denjhang/FM-Tower/ym2610_chip_sample.jpg

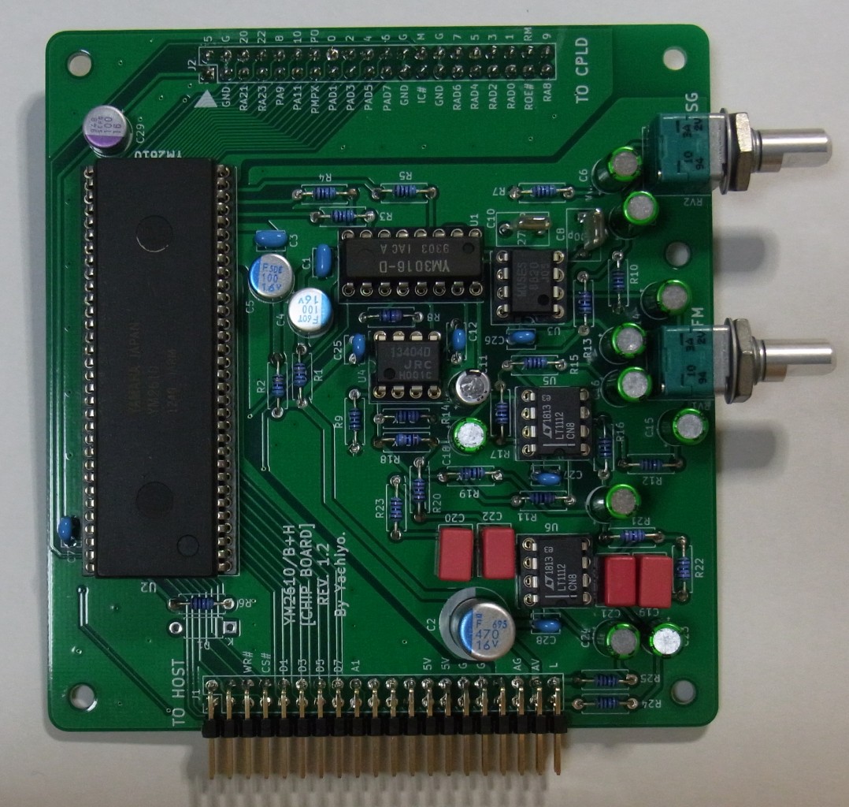
ym2610_chip_sample.jpg
