denjhang/FM-Tower/DAC_Unit_Rev1_0.png

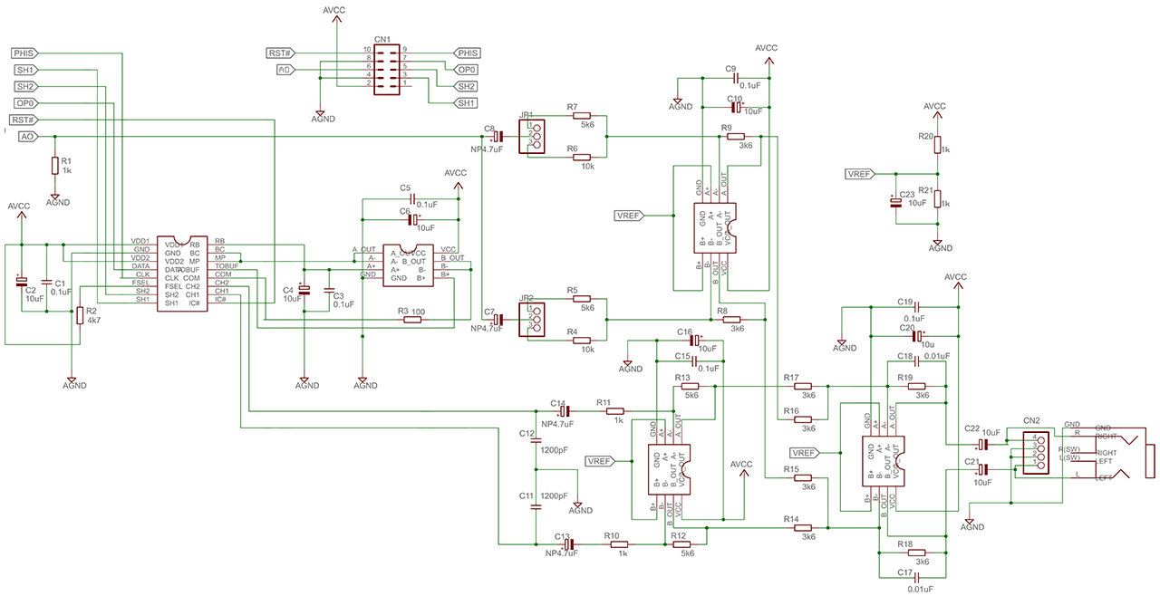
DAC_Unit_Rev1_0.png
