denjhang/FM-Tower/IF_Unit_Rev1_0b.png

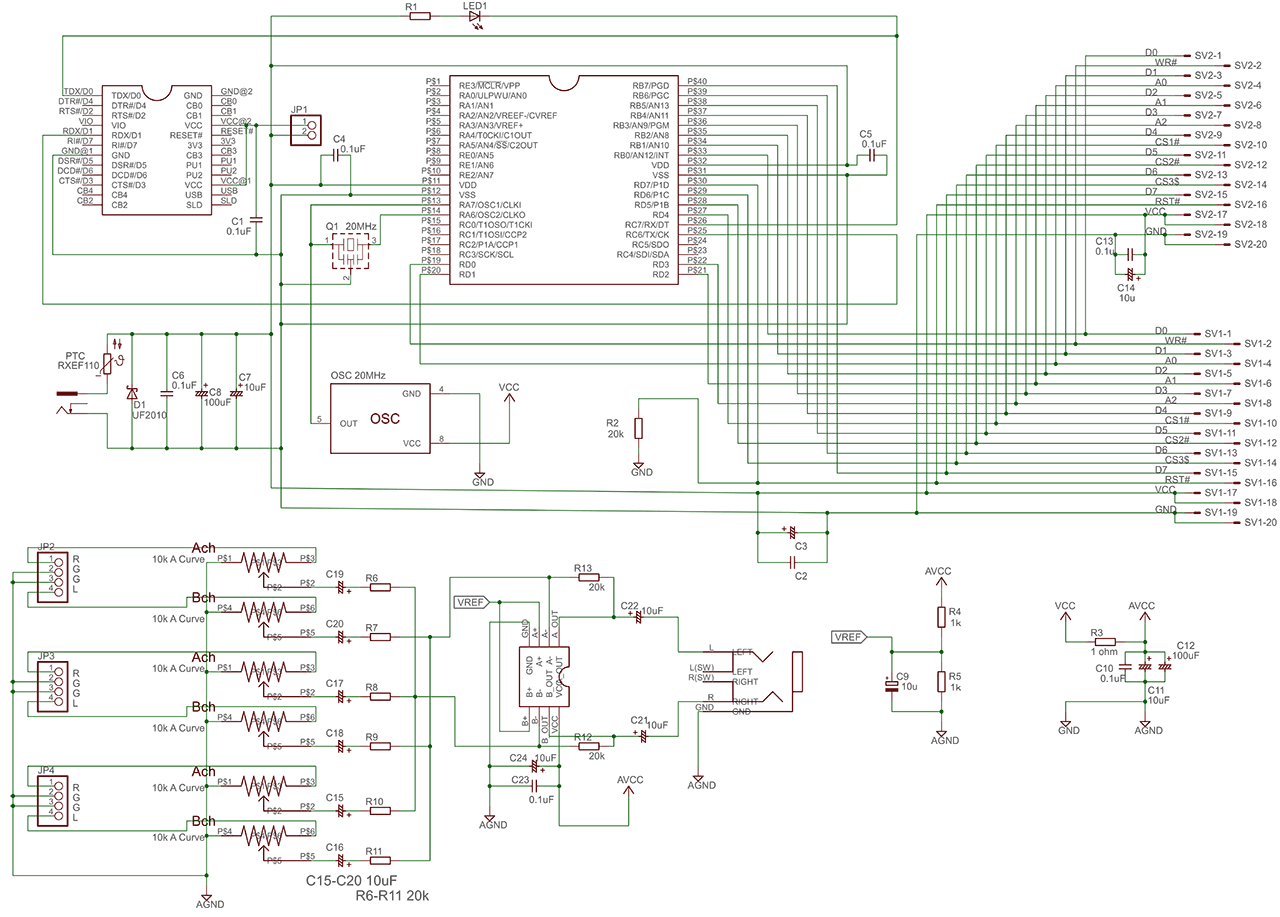
IF_Unit_Rev1_0b.png
