denjhang/FM-Tower/YM2151_Unit_Rev1_0.png

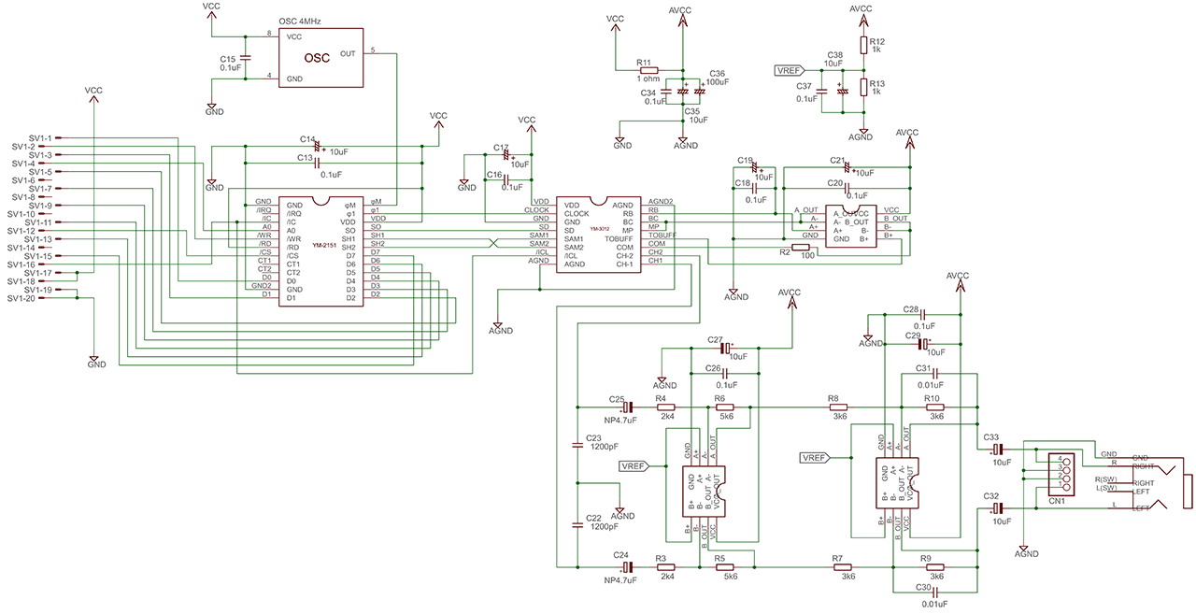
YM2151_Unit_Rev1_0.png
