denjhang/FM-Tower/ym2610_board.png

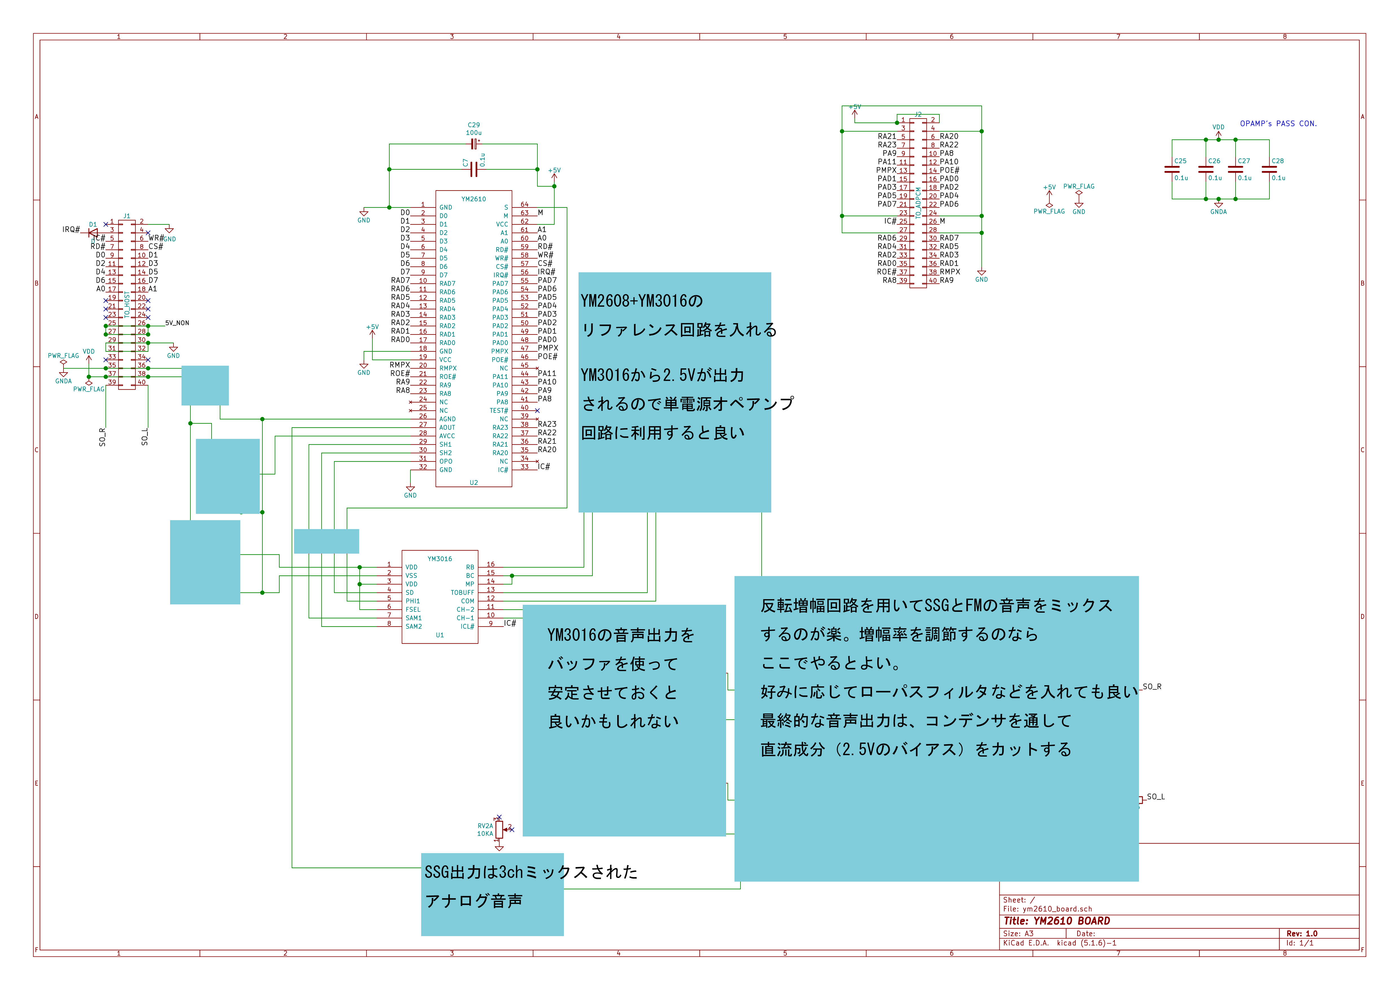
ym2610_board.png
