denjhang/FM-Tower/YM2610_Unit_Rev2_1.png

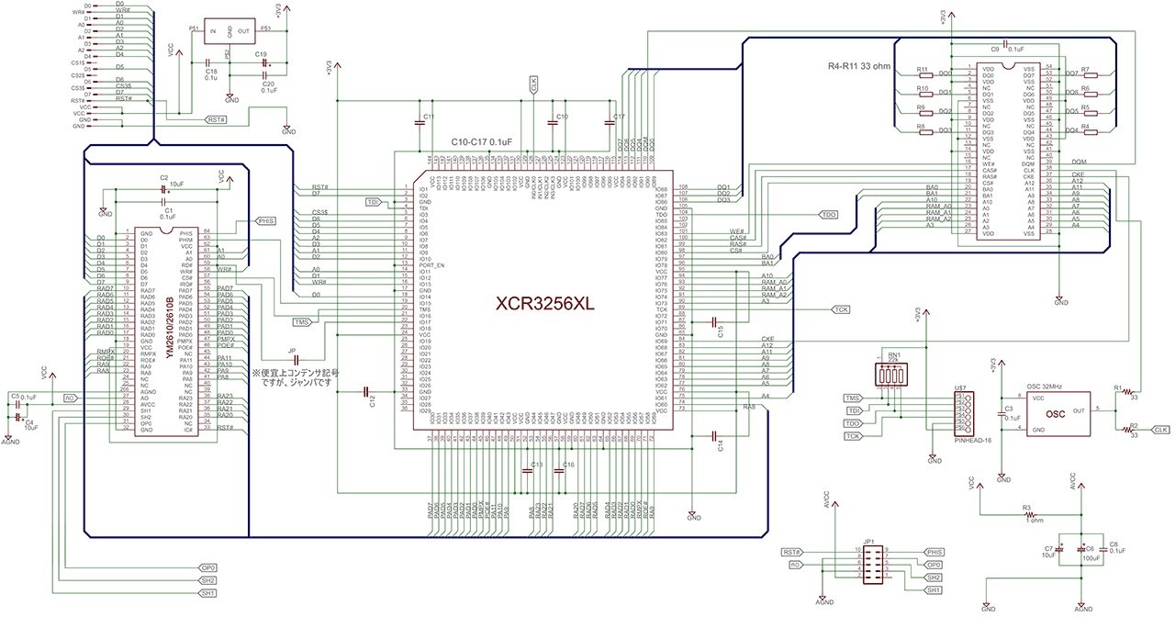
YM2610_Unit_Rev2_1.png
