denjhang/FM-Tower/YM2608_Unit_FIX@2x.png

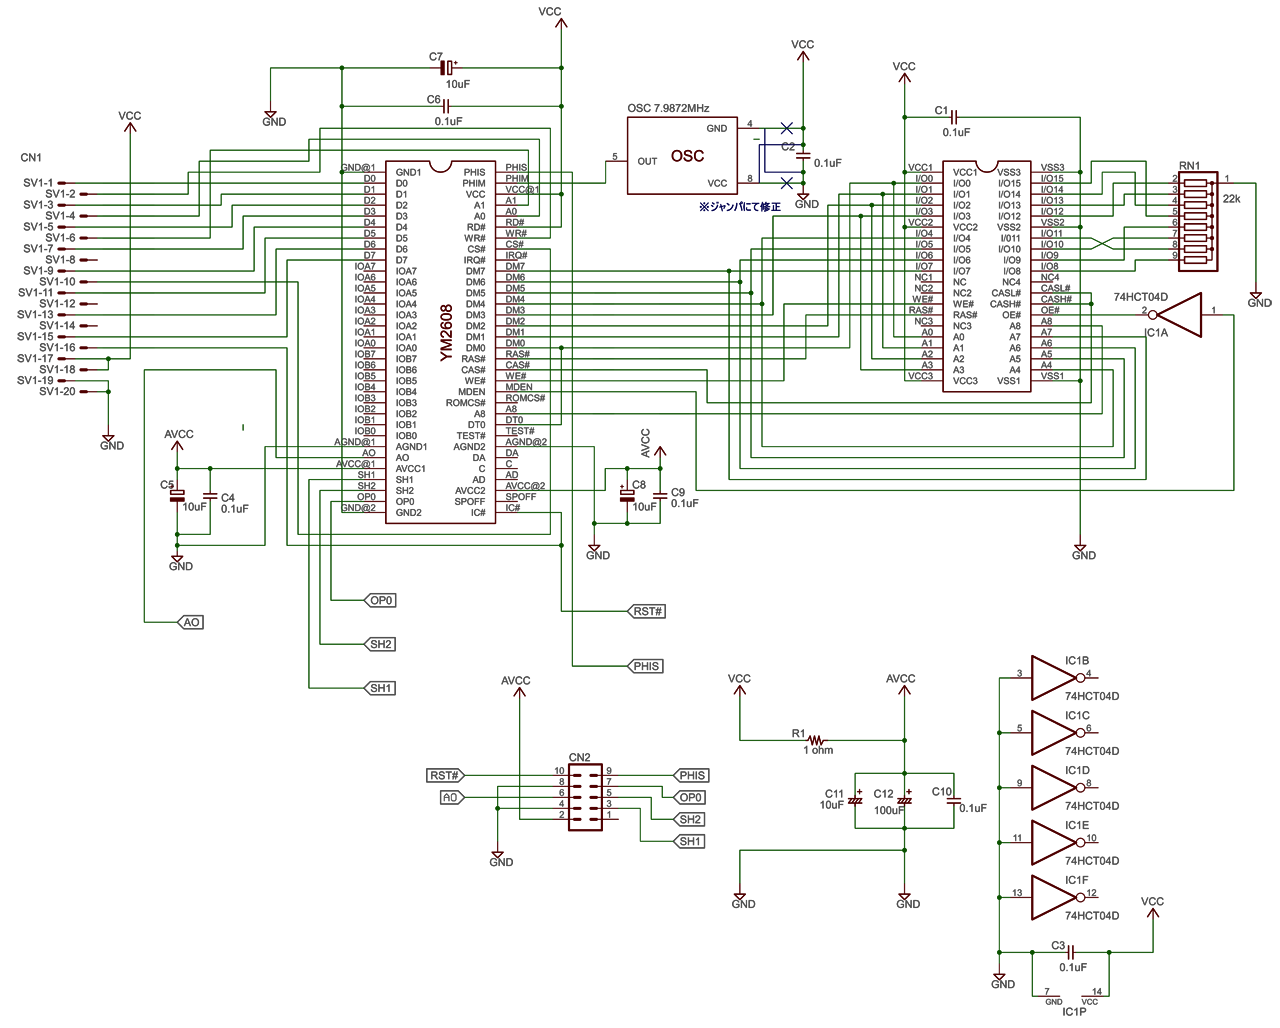
YM2608_Unit_FIX@2x.png
