denjhang/FM-Tower/altera_ymb_cpld_scheme.pdf

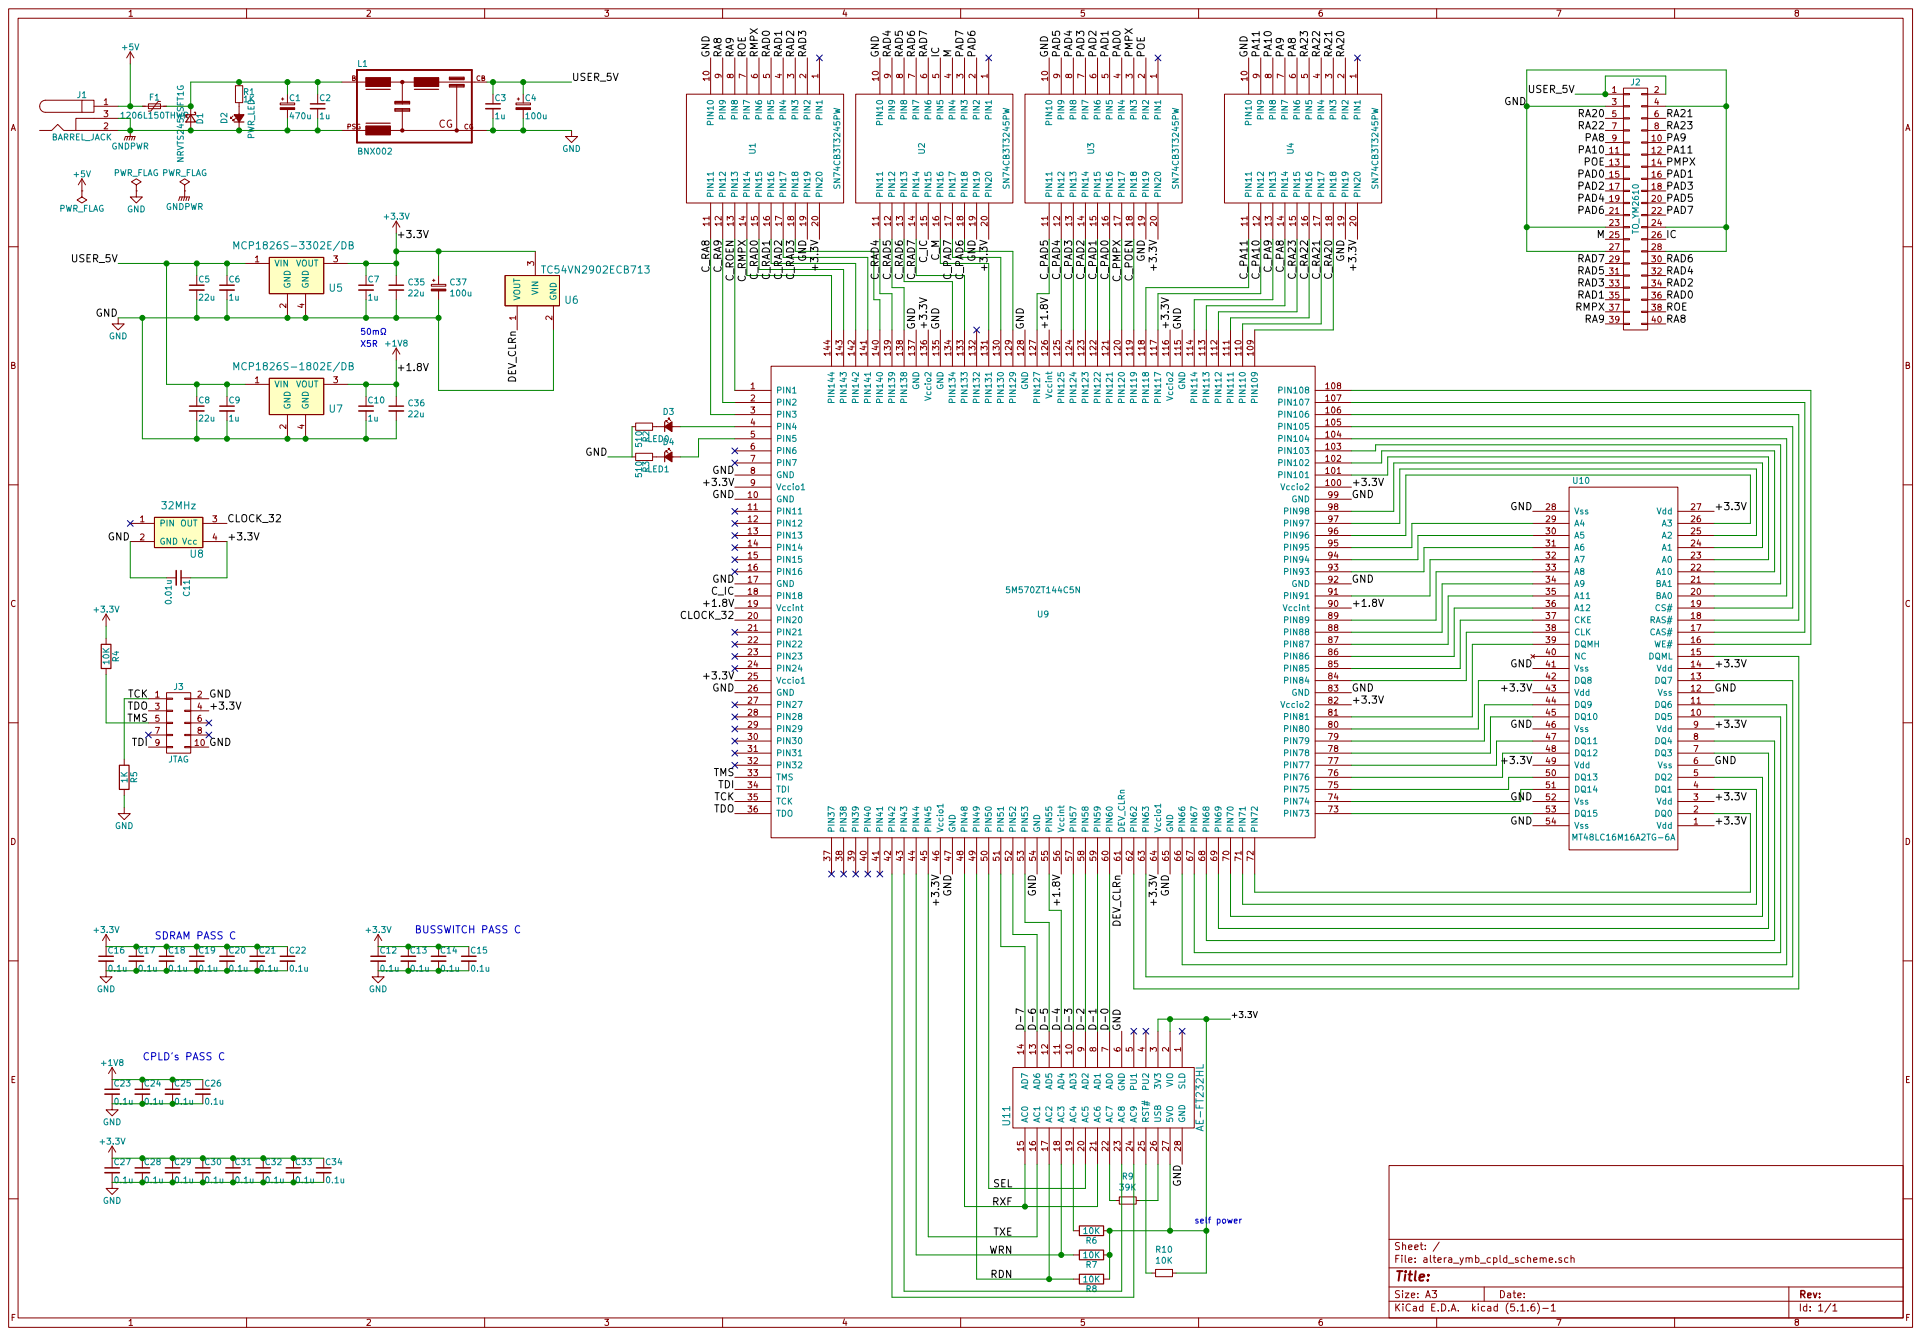
[picture p12: page 1]

File: altera_ymb_cpld_scheme.sch Sheet: / +3.3V GND
