denjhang/FM-Tower/udpl_mother_r13.pdf

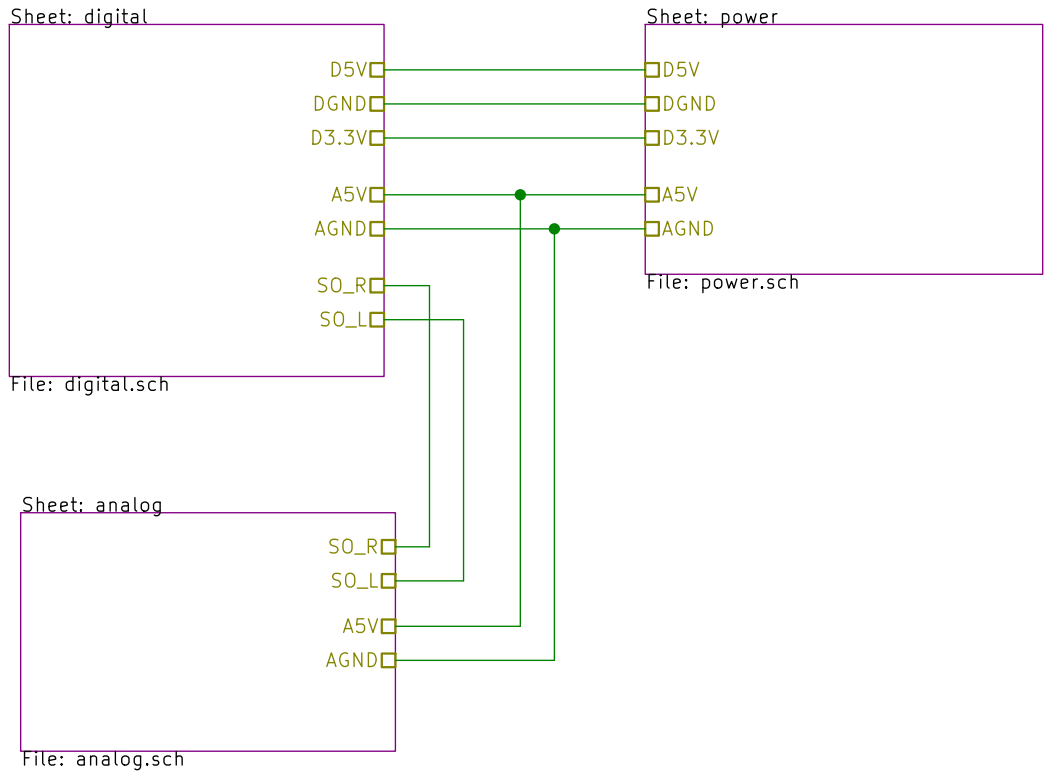
[picture p13: page 1]

File: power.sch D5V DGND

File: udpl_mother.sch Sheet: / yachiyo

Id: 1/4 Title: WiFi and PLL sound mother

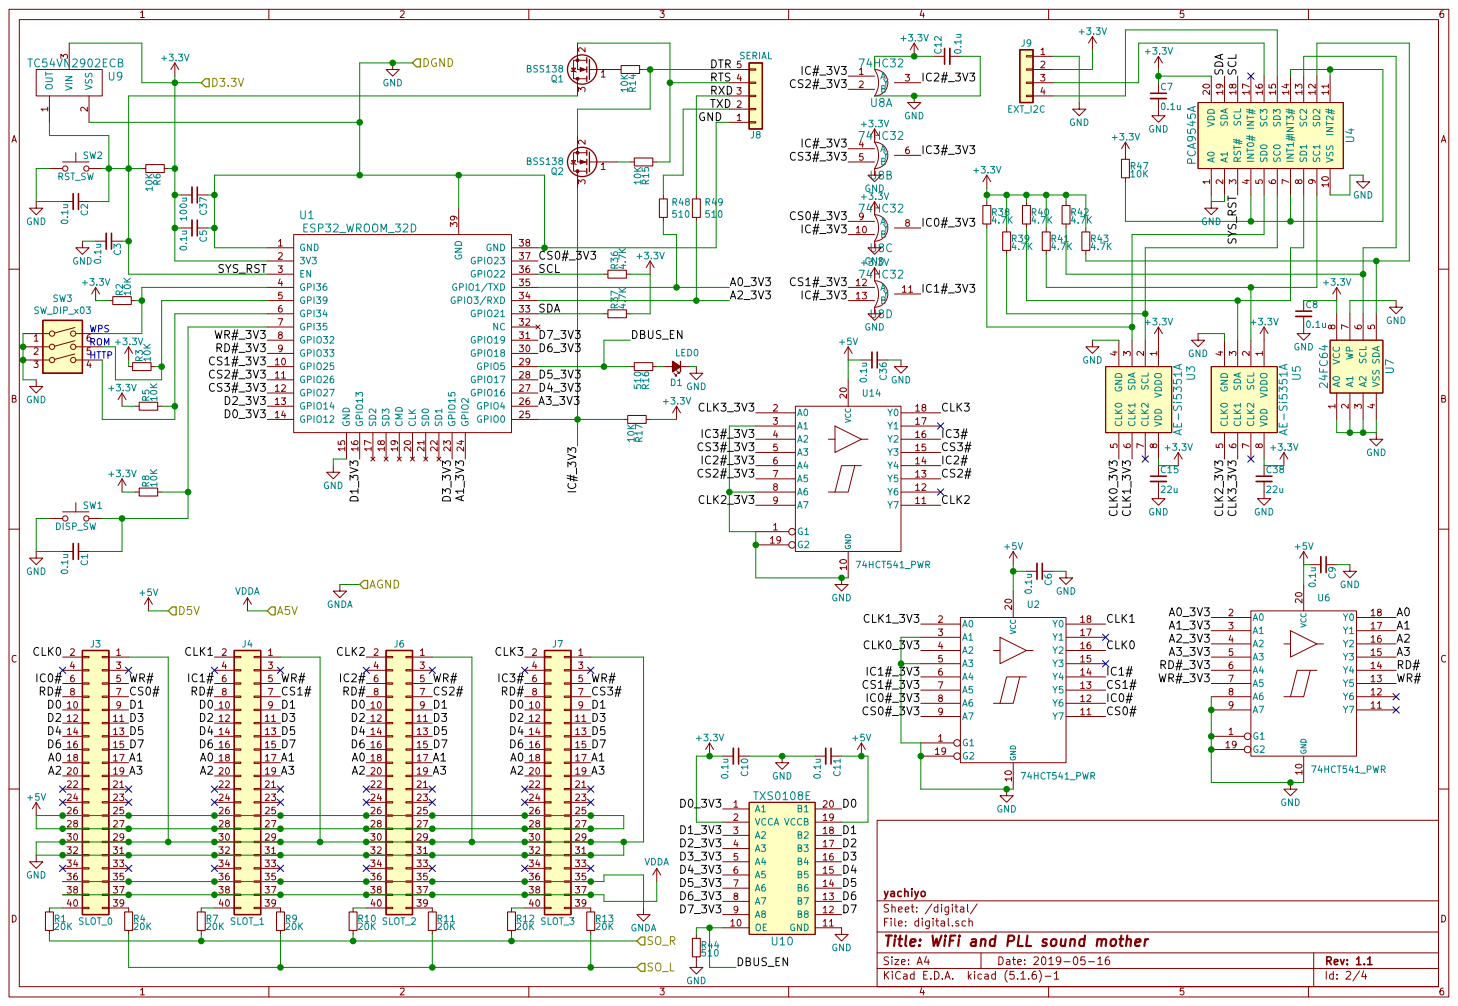
[picture p14: page 2]

9 VSS 10 VDD 20 INT2# 11 SD2 12 SC2 13 INT3# 14 SD3 15 SC3 16 INT# 17 SCL 18 SDA 19 U4 PCA9545A

TXD 2

yachiyo
Sheet: /digital/
File: digital.sch
Id: 2/4 Title: WiFi and PLL sound mother

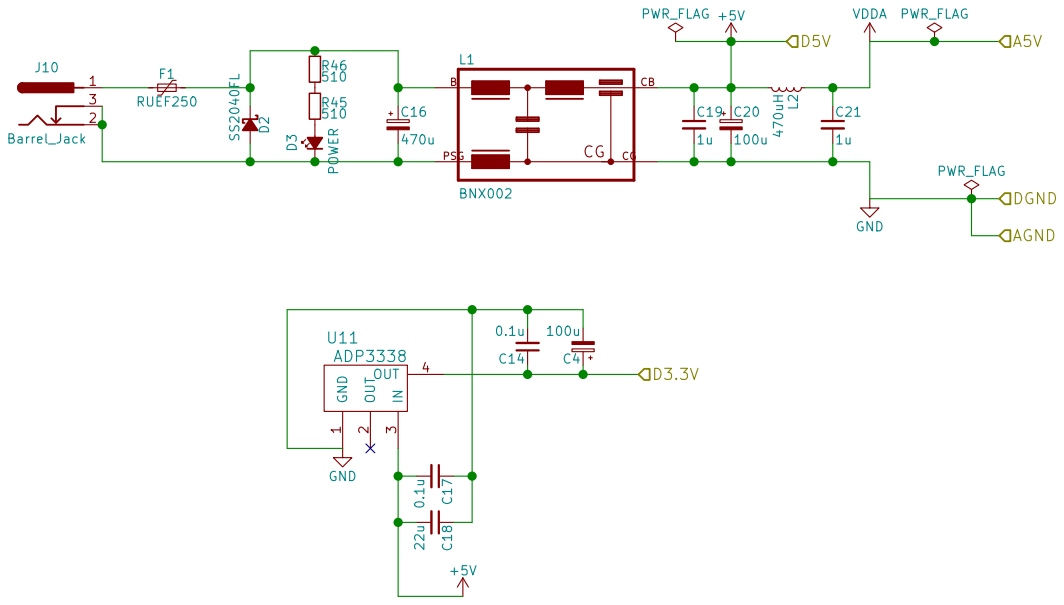
[picture p15: page 3]

yachiyo
Sheet: /power/
File: power.sch
Id: 3/4 Title: WiFi and PLL sound mother

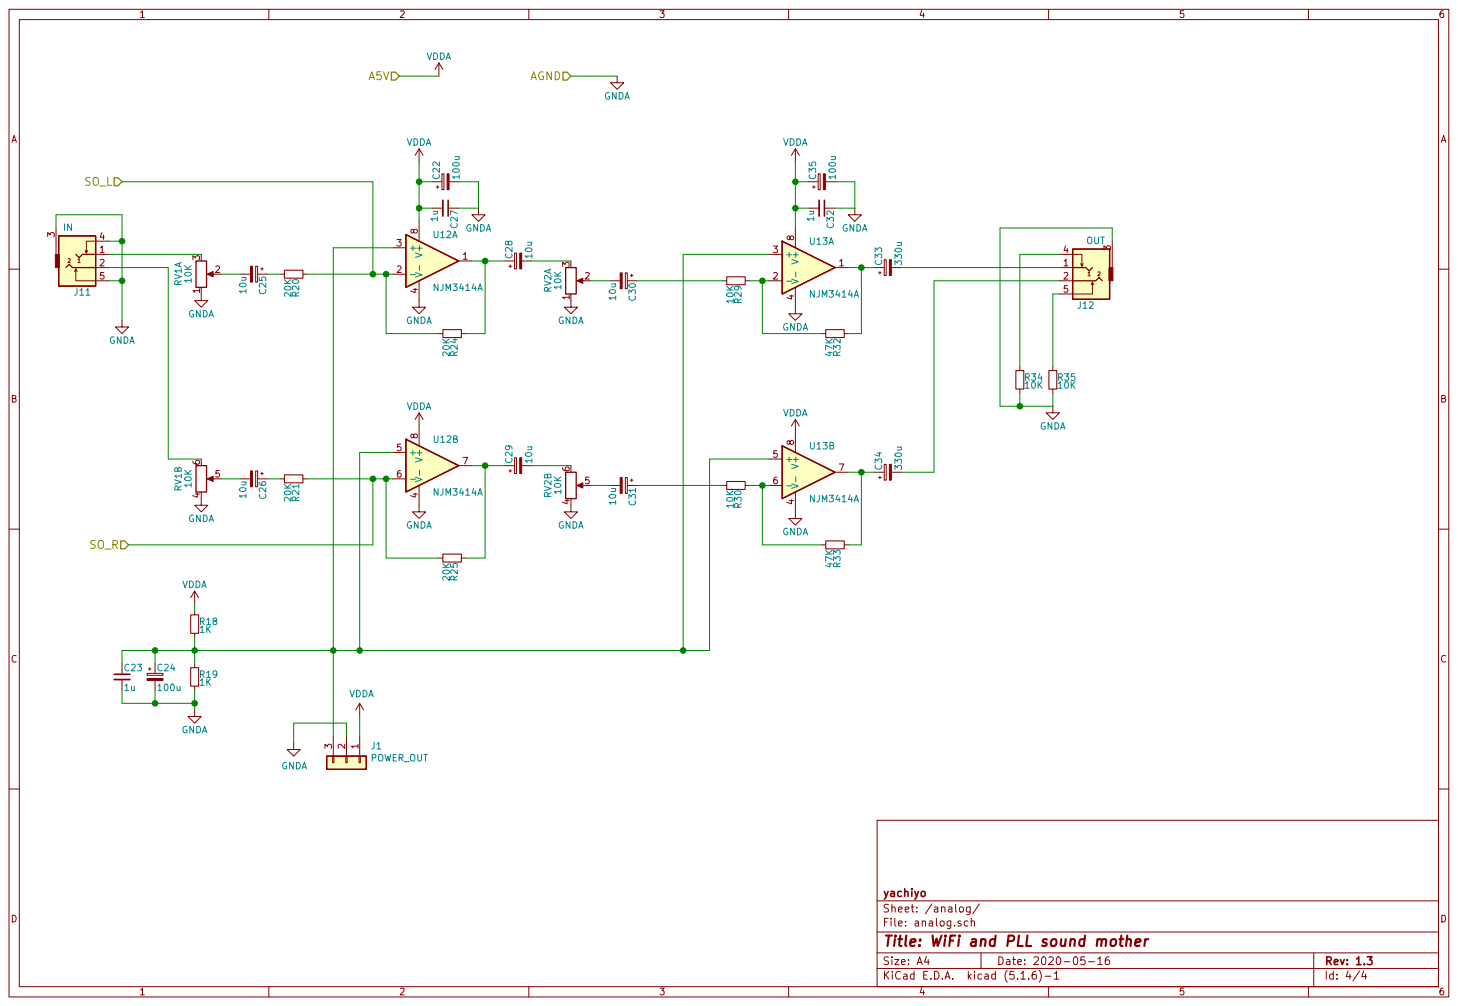
[picture p16: page 4]

yachiyo
Sheet: /analog/
File: analog.sch
Id: 4/4 Title: WiFi and PLL sound mother
